GrzegorzewskiSzymon/STM32_TFT_RF/KiCad/TFT_RF_1.0.kicad_pcb

## KiCad design KiCad/TFT_RF_1.0.kicad_pcb (2023-06-03)

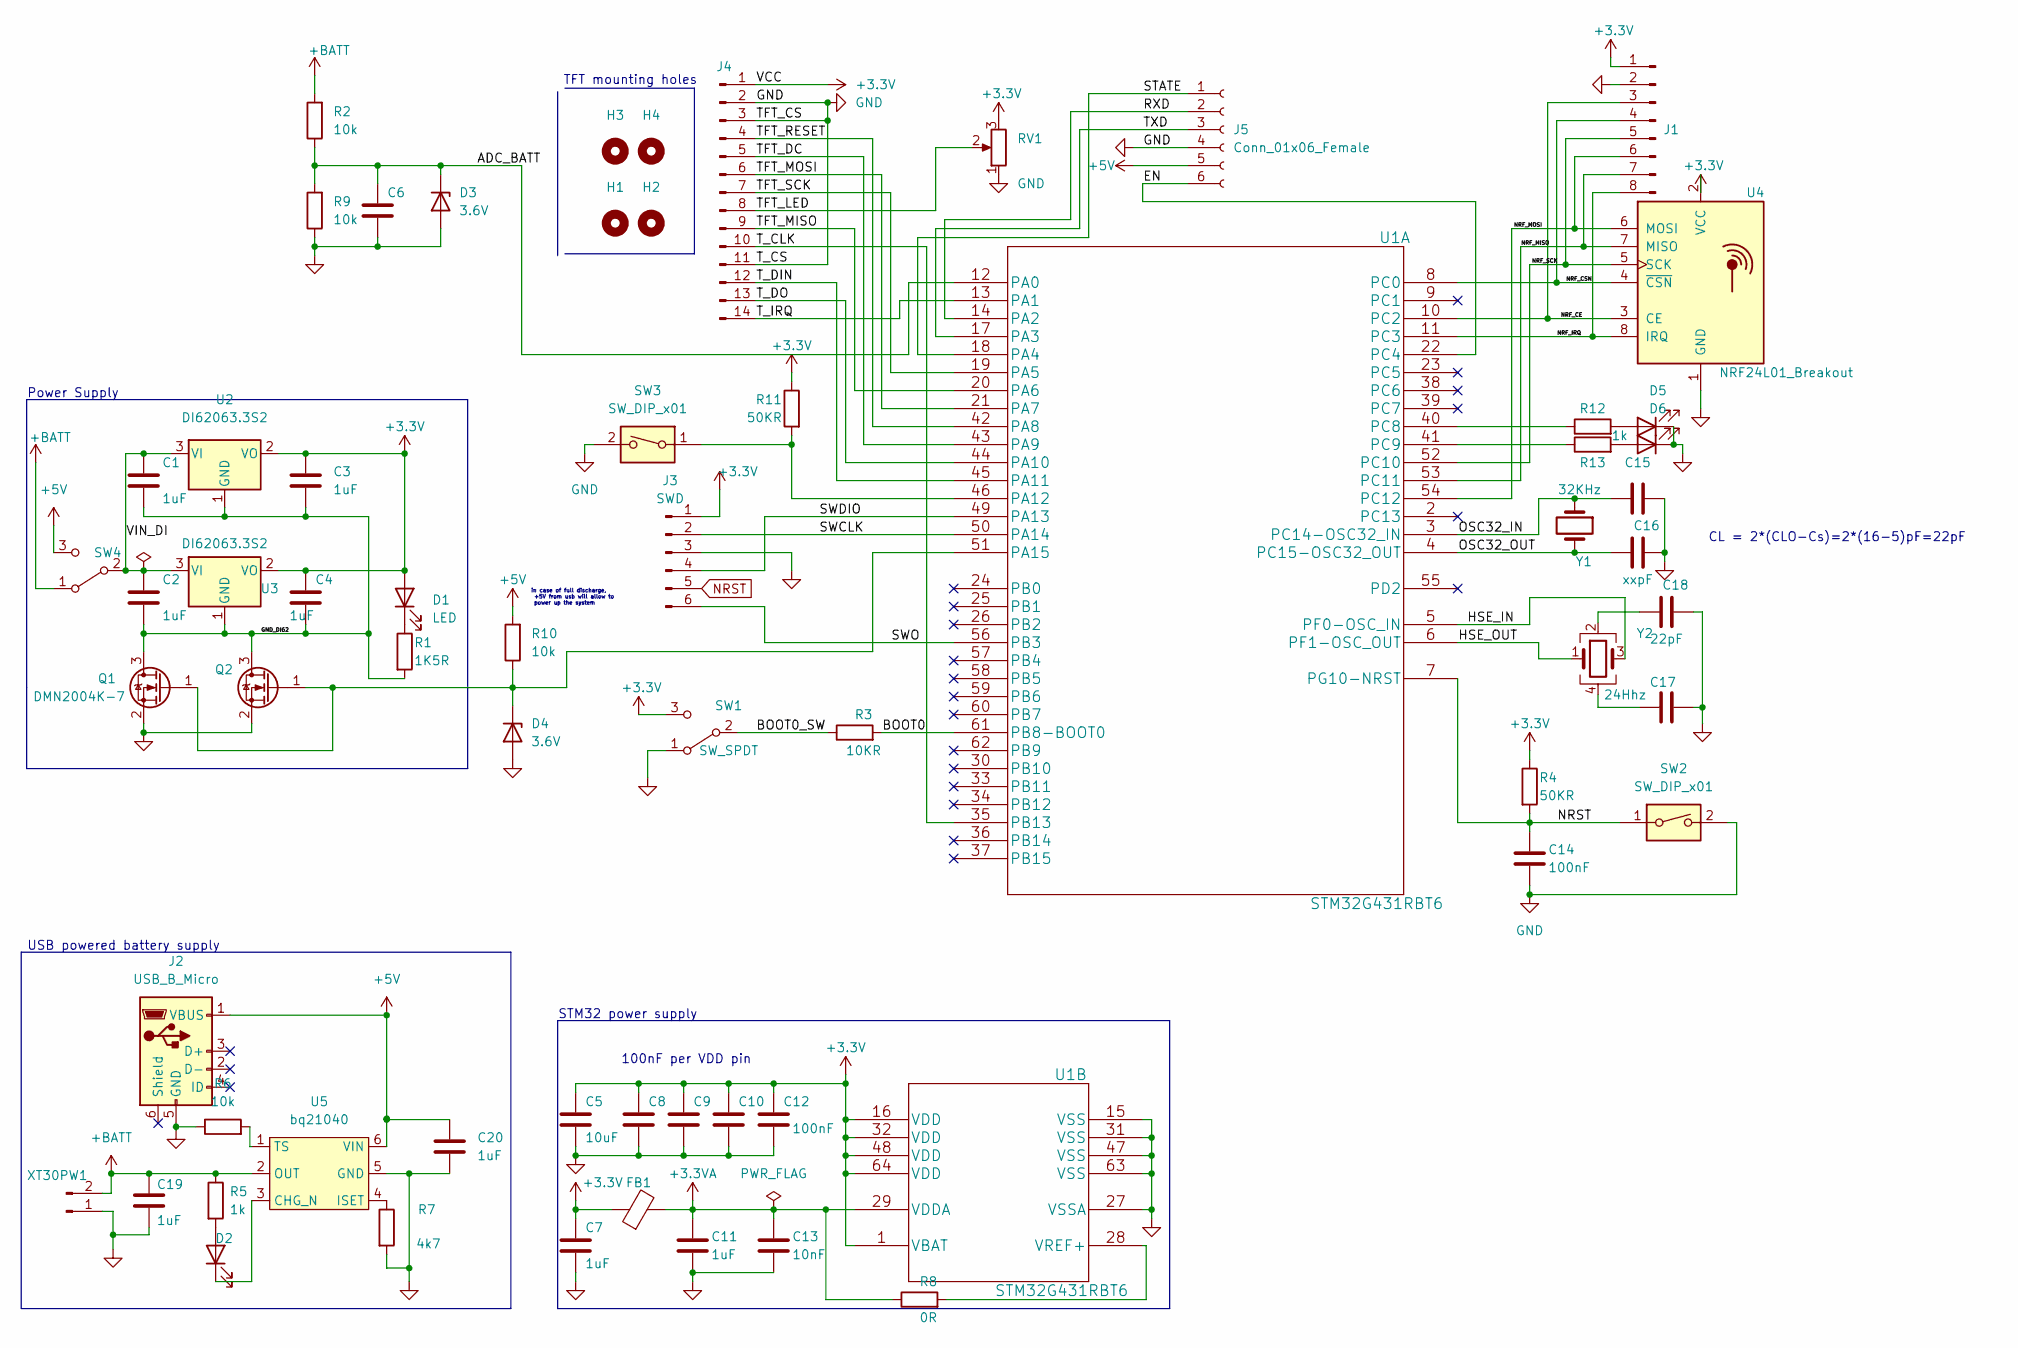
[picture p1: schematic TFT_RF_1.0.kicad_sch, STM32G431RBT6 TFT_RF]

Parts:
C1, C2, C3, C4, C7, C11, C19, C20: 1uF; L_0805_2012Metric_Pad1.15x1.40mm_HandSolder
C5: 10uF; L_0805_2012Metric_Pad1.15x1.40mm_HandSolder
C6, C8, C9, C10, C12, C14: 100nF; L_0805_2012Metric_Pad1.15x1.40mm_HandSolder
C13: 10nF; L_0805_2012Metric_Pad1.15x1.40mm_HandSolder
C15, C16: xxpF; L_0805_2012Metric_Pad1.15x1.40mm_HandSolder
C17, C18: 22pF; L_0805_2012Metric_Pad1.15x1.40mm_HandSolder
D1, D2, D5, D6: LED; R_0805_2012Metric_Pad1.20x1.40mm_HandSolder
D3, D4: 3.6V; Nexperia_CFP3_SOD-123W
FB1: 120R 100MHz; BDS
H1, H2, H3, H4: MountingHole; MountingHole_3.2mm_M3
J1: Conn_01x08_Male; PinHeader_1x08_P1.27mm_Vertical
J2: USB_B_Micro; USB_Micro-B_Molex_47346-0001
J3: SWD; PinHeader_1x06_P2.54mm_Vertical
J4: Conn_01x14_Male; PinHeader_1x14_P2.54mm_Vertical
J5: Conn_01x06_Female; PinSocket_1x06_P2.54mm_Vertical
Q1, Q2: DMN2004K-7; SOT-23
R1: 1K5R; R_1206_3216Metric_Pad1.30x1.75mm_HandSolder
R2, R6, R9, R10: 10k; R_1206_3216Metric_Pad1.30x1.75mm_HandSolder
R3: 10KR; R_1206_3216Metric_Pad1.30x1.75mm_HandSolder
R4, R11: 50KR; R_1206_3216Metric_Pad1.30x1.75mm_HandSolder
R5, R12, R13: 1k; R_1206_3216Metric_Pad1.30x1.75mm_HandSolder
R7: 4k7; R_1206_3216Metric_Pad1.30x1.75mm_HandSolder
R8: 0R; R_1206_3216Metric_Pad1.30x1.75mm_HandSolder
RV1: R_Potentiometer; Potentiometer_ACP_CA9-H5_Horizontal
SW1, SW4: SW_SPDT; os102011
SW2, SW3: SW_DIP_x01; SW_PUSH_6mm_H4.3mm
U1: STM32G431RBT6; LQFP-64_10x10mm_P0.5mm
U2, U3: DI62063.3S2; SOT-23
U4: NRF24L01_Breakout; nRF24L01_Breakout
U5: bq21040; TSOT-23-6_HandSoldering
XT30PW1: Conn_01x02_Male; AMASS_XT30PW-M_1x02_P2.50mm_Horizontal
Y1: 32KHz; Crystal_DS10_D1.0mm_L4.3mm_Horizontal_1EP_style2
Y2: 24Hhz; Crystal_SMD_SeikoEpson_FA238-4Pin_3.2x2.5mm_HandSoldering

Connections:
+3.3V: C3.1, C4.1, C5.1, C7.1, C8.1, C9.1, C10.1, C12.1, D1.2 (A), FB1.1, J1.1, J3.1, J4.1, R4.1, R11.1, RV1.3, SW1.3 (C), U1.1 (VBAT), U1.16 (VDD), U1.32 (VDD), U1.48 (VDD), U1.64 (VDD), U2.2 (VO), U3.2 (VO), U4.2 (VCC)
+3.3VA: C11.1, C13.1, FB1.2, R8.1, U1.29 (VDDA)
+5V: C20.1, J2.1 (VBUS), J5.5, R10.2, SW4.3 (C), U5.6 (VIN)
+BATT: C19.1, R2.2, R5.1, SW4.1 (A), U5.2 (OUT), XT30PW1.2
/ADC_BATT: C6.1, D3.1 (K), R2.1, R9.2, U1.12 (PA0)
/BOOT0: R3.2, U1.61 (PB8-BOOT0)
/BOOT0_SW: R3.1, SW1.2 (B)
/EN: J5.6, U1.22 (PC4)
/GND_DI62: C1.2, C2.2, C3.2, C4.2, Q1.3 (D), Q2.3 (D), R1.2, U2.1 (GND), U3.1 (GND)
/HSE_IN: U1.5 (PF0-OSC_IN), Y2.3
/HSE_OUT: U1.6 (PF1-OSC_OUT), Y2.1
/NRF_CE: J1.3, U1.10 (PC2), U4.3 (CE)
/NRF_CSN: J1.4, U1.8 (PC0), U4.4 (~CSN)
/NRF_IRQ: J1.8, U1.11 (PC3), U4.8 (IRQ)
/NRF_MISO: J1.7, U1.53 (PC11), U4.7 (MISO)
/NRF_MOSI: J1.6, U1.54 (PC12), U4.6 (MOSI)
/NRF_SCK: J1.5, U1.52 (PC10), U4.5 (SCK)
/OSC32_IN: C15.1, U1.3 (PC14-OSC32_IN), Y1.1
/OSC32_OUT: C16.1, U1.4 (PC15-OSC32_OUT), Y1.2
/RXD: J5.2, U1.14 (PA2)
/STATE: J5.1, U1.18 (PA4)
/SWCLK: J3.2, U1.50 (PA14)
/SWDIO: J3.4, U1.49 (PA13)
/SWO: J3.6, U1.56 (PB3)
/TFT_DC: J4.5, U1.43 (PA9)
/TFT_LED: J4.8, RV1.2
/TFT_MISO: J4.9, U1.20 (PA6)
/TFT_MOSI: J4.6, U1.21 (PA7)
/TFT_RESET: J4.4, U1.42 (PA8)
/TFT_SCK: J4.7, U1.19 (PA5)
/TXD: J5.3, U1.17 (PA3)
/T_CLK: J4.10, U1.35 (PB13)
/T_DIN: J4.12, U1.45 (PA11)
/T_DO: J4.13, U1.44 (PA10)
/T_IRQ: J4.14, U1.13 (PA1)
/VIN_DI: C1.1, C2.1, SW4.2 (B), U2.3 (VI), U3.3 (VI)
GND: C5.2, C6.2, C7.2, C8.2, C9.2, C10.2, C11.2, C12.2, C13.2, C14.2, C15.2, C16.2, C17.1, C18.2, C19.2, C20.2, D3.2 (A), D4.2 (A), D5.1 (K), D6.1 (K), J1.2, J2.5 (GND), J3.3, J4.2, J4.3, J4.11, J5.4, Q1.2 (S), Q2.2 (S), R6.1, R7.2, R9.1, RV1.1, SW1.1 (A), SW2.2, SW3.2, U1.15 (VSS), U1.27 (VSSA), U1.31 (VSS), U1.47 (VSS), U1.63 (VSS), U4.1 (GND), U5.5 (GND), XT30PW1.1
NRST: C14.1, J3.5, R4.2, SW2.1, U1.7 (PG10-NRST)
unnamed: C17.2, Y2.4
unnamed: C18.1, Y2.2
unnamed: D1.1 (K), R1.1
unnamed: D2.1 (K), U5.3 (CHG_N)
unnamed: D2.2 (A), R5.2
unnamed: D5.2 (A), R12.2
unnamed: D6.2 (A), R13.2
unnamed: D4.1 (K), Q1.1 (G), Q2.1 (G), R10.1, U1.51 (PA15)
unnamed: R6.2, U5.1 (TS)
unnamed: R7.1, U5.4 (ISET)
unnamed: R8.2, U1.28 (VREF+)
unnamed: R12.1, U1.40 (PC8)
unnamed: R13.1, U1.41 (PC9)
unnamed: R11.2, SW3.1, U1.46 (PA12)

Notes on the sheet:
STM32 power supply
USB powered battery supply
100nF per VDD pin
TFT mounting holes
in case of full discharge, +5V from usb will allow to power up the system
CL = 2*(CLO-Cs)=2*(16-5)pF=22pF
Power Supply

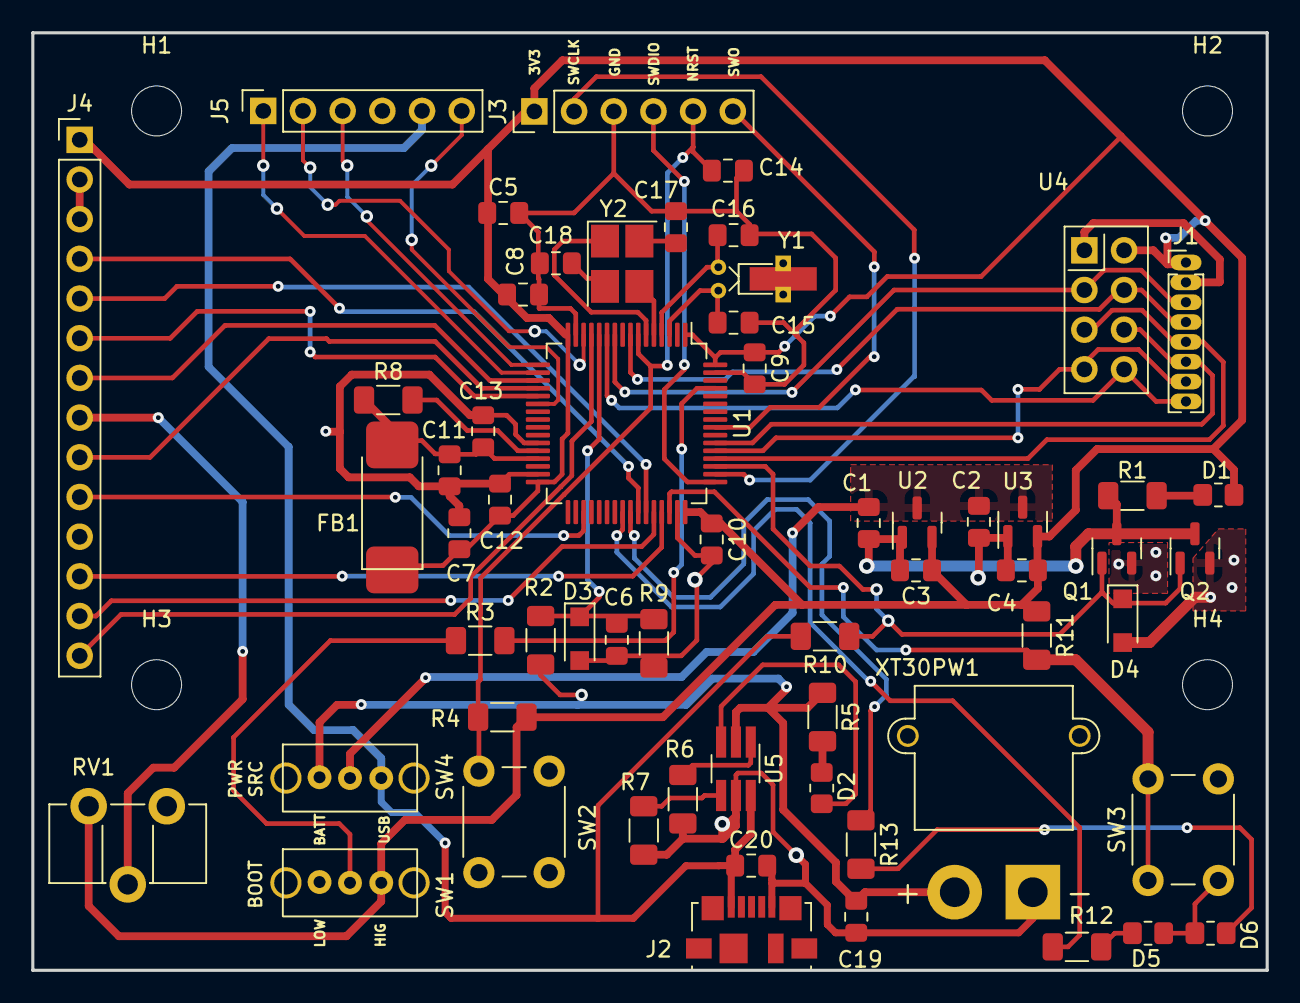
[picture p2: board TFT_RF_1.0.kicad_pcb from above]

Board: 2 copper layers, 79.0 x 60.0 mm, 64 parts (0 on the bottom side), 52 nets.
