GrzegorzewskiSzymon/STM32_TFT_RF/(commit log)

2023-01-13 attach pins to spi2 (xtp2046)
    configure interrupt form PB3 (on line EXTI3) and add handler
2023-01-15 add full handling of detecting a touch and then take samples
2023-01-16 add NRF24L01 files and attach SPI3
2023-01-16 attach pins to spi3
2023-02-10 change pinout on spi 3 (RegistersConfig.*)
    fix receiving functions (RegistersConfig.c)
    change initialization from transmitting to receiving (main.c)
    [main.c]
2023-02-17 add initializations of pins for battery management create BatteryManagement files
2023-02-18 replace not stable functions for receiving (spi3) and implement them into NRF24L01
    previously NRF24L01_Receive() received halfway wrong data
    and NRF24L01_ReadReg(uint8_t reg) was overengineered due to bugs in receiving
    [main.c]
2023-02-24 add ADC1 initialization and single channel conversion
    to monitor the battery voltage
2023-02-27 add TIM3 to activate ADC conversion cyclically
    conversion have interval of 1s, then after receiving
    interrupt from ADC, we handle it and transfer data to
    uint16_t battRawVoltageData
2023-03-02 add internal calibration of ADC1
2023-03-03 add CalculateBattVolatage() function
    and improve code clarity
    all battery related data is stored in (struct battery)
2023-03-05 add displaying buttons in DesktopLayer
2023-03-05 add settings button
2023-03-05 add function to display button
2023-03-09 add: display voltage and battery percentage every second
2023-03-09 add image to every button
2023-03-09 fix battery percentage calculation
2023-03-10 initialize TouchScreen, attach pins to spi2 and EXTI1
2023-03-11 add a state machine to identify if any button is touched
2023-03-11 Exclude possibility of occurring interrupt witch another drawing function while drawing a layer
2023-03-11 Add layer to control RGB leds
2023-03-21 -add: prevent multiple read of one touch -add: button to change rotation of TFT -fix: reading touched point in horizontal rotation
    [main.c]
2023-03-21 add: prevent from draining battery below 3.7V
2023-05-29 fix bit operations controlling MOSFETS
2023-05-29 Add buffer of battery voltage samples to improve stability of calculations
2023-06-03 Add schematics and pcb layout with extracted gerber files
    [TFT_RF_1.0-B_Cu.gbr, TFT_RF_1.0-B_Mask.gbr, TFT_RF_1.0-B_Paste.gbr, TFT_RF_1.0-B_Silkscreen.gbr, TFT_RF_1.0-Edge_Cuts.gbr, TFT_RF_1.0-F_Cu.gbr, TFT_RF_1.0-F_Mask.gbr, TFT_RF_1.0-F_Paste.gbr]
